poanessa/RobotHead/3D_printedObjects/Lips/20161202_165450.jpg

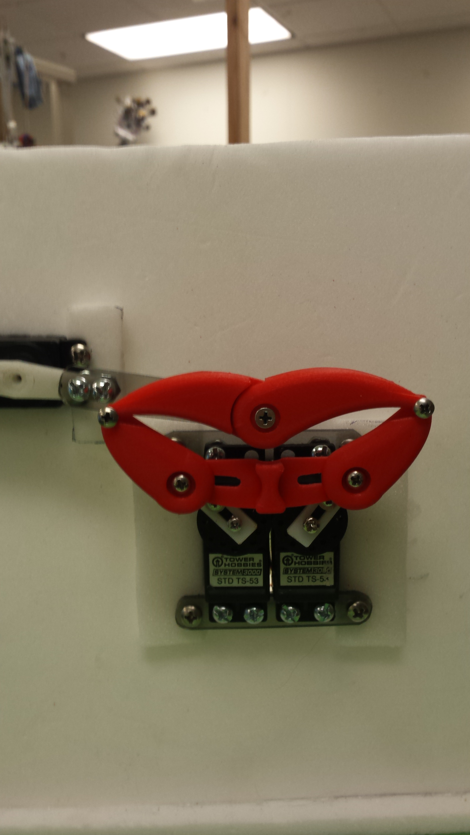
3D_printedObjects/Lips/20161202_165450.jpg
