poanessa/RobotHead/README.md

# RobotHead

Welcome to the PSU Robotics Department's robot head repository.<p>
Here you will find all files related to the production of the robot head created in in the 2016-2017 school term.<p>
This project was created by Tuna Poanessa (hardware) and Daniel Diaz (software).<p>
Have questions?  Please feel free to email me at poanessa@gmail.com
