poanessa/RobotHead/media/InternalStruc/readMe

This folder contains the finished assembly of the internal eyelid and eye structures
