poanessa/RobotHead/media/FinishedMech/ReadMe

This Folder shows the final assembly of the head mechanisms.
