poanessa/RobotHead/20170429_133849.jpg

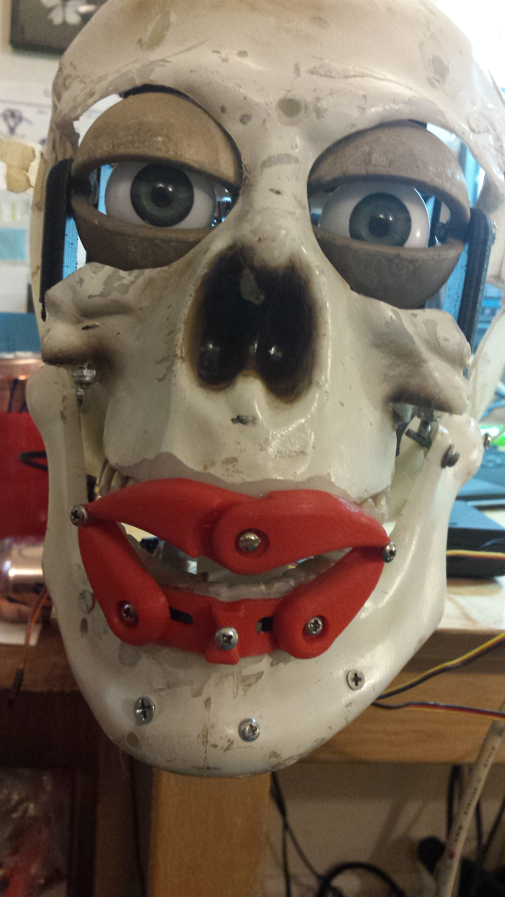
20170429_133849.jpg
