poanessa/RobotHead/media/20160930_150606.jpg

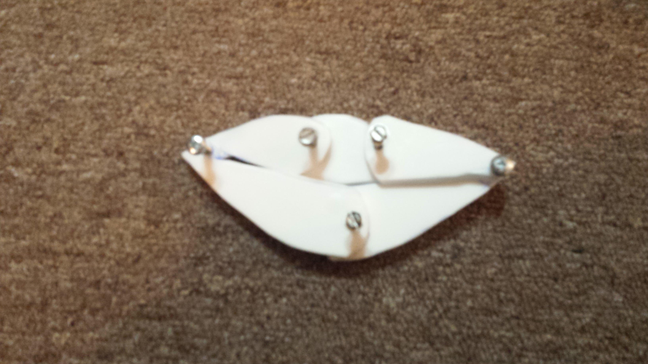
media/20160930_150606.jpg
