poanessa/RobotHead/media/20160930_150606_2.jpg

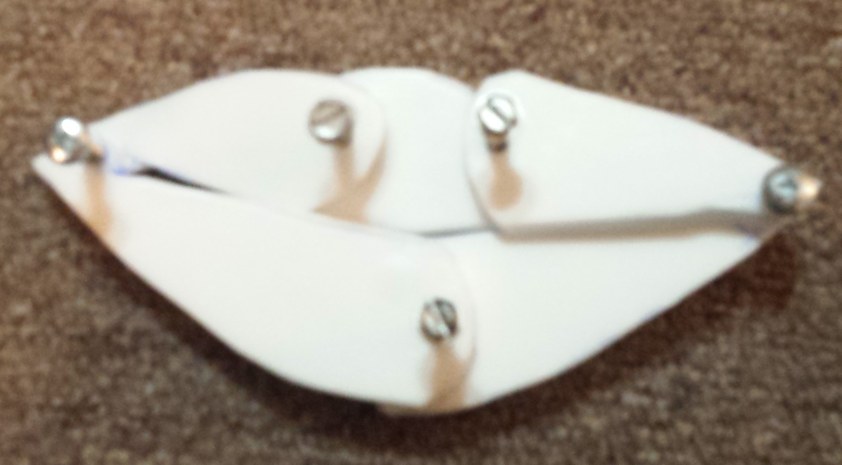
media/20160930_150606_2.jpg
