poanessa/RobotHead/media/20160930_150614.jpg

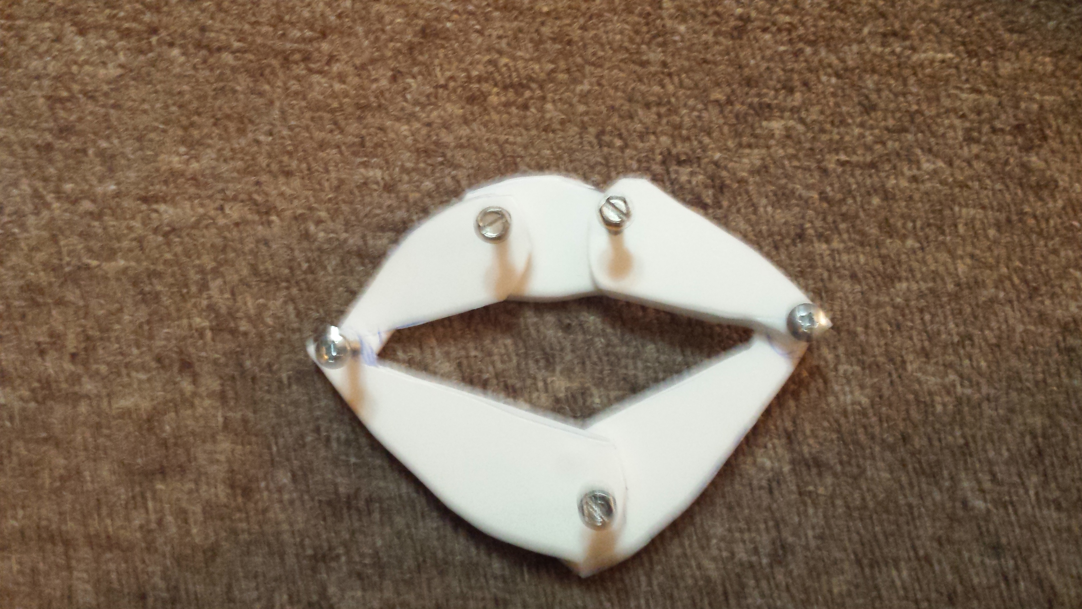
media/20160930_150614.jpg
