poanessa/RobotHead/media/20160930_150614_2.jpg

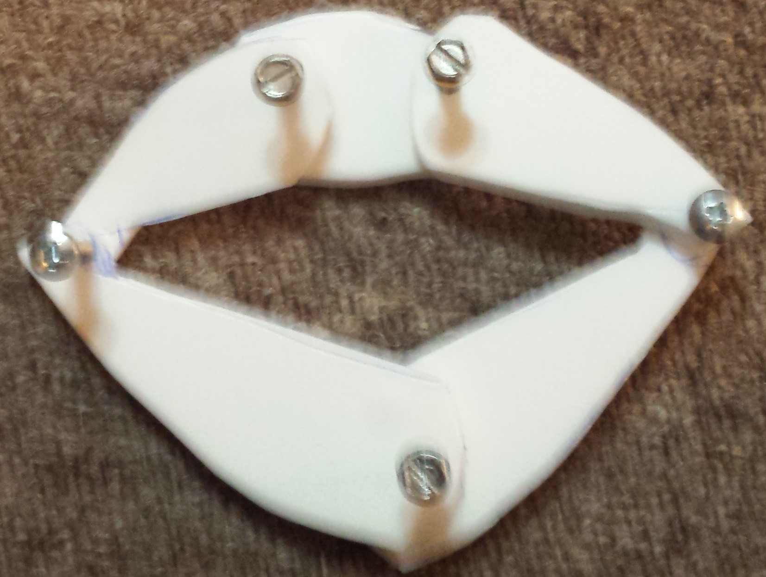
media/20160930_150614_2.jpg
