poanessa/RobotHead/media/20161104_113612.jpg

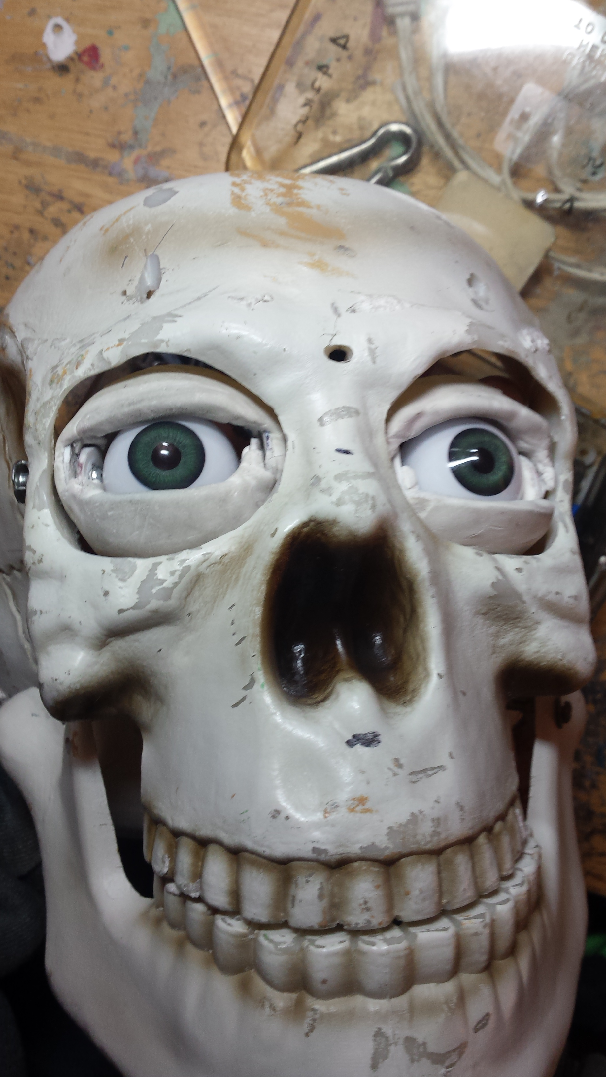
media/20161104_113612.jpg
