poanessa/RobotHead/media/20161111_124247.jpg

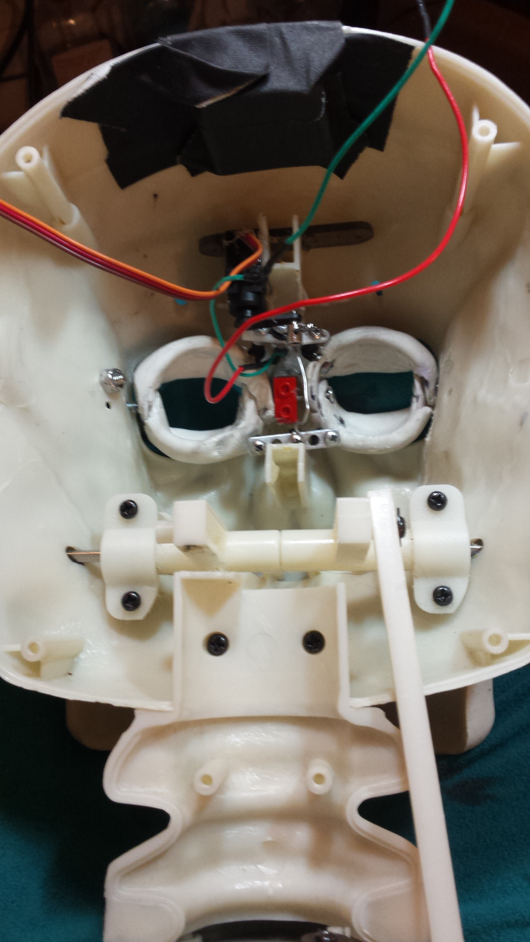
media/20161111_124247.jpg
