poanessa/RobotHead/media/20161127_152731.jpg

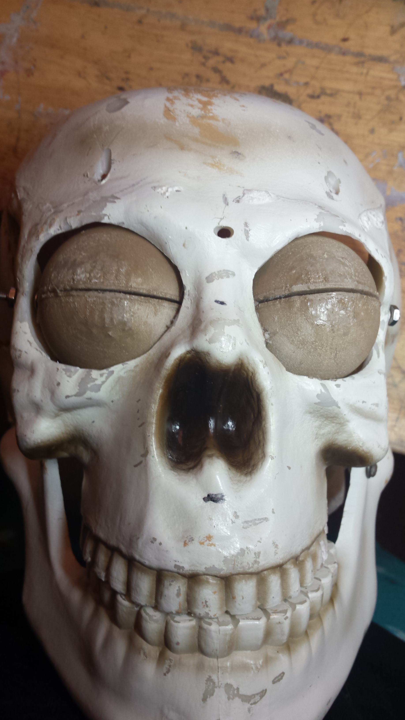
media/20161127_152731.jpg
