poanessa/RobotHead/media/20161127_152739.jpg

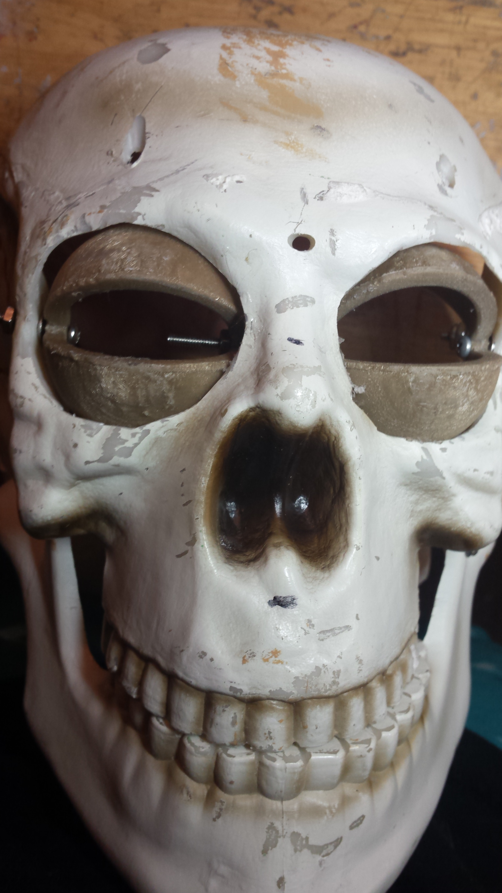
media/20161127_152739.jpg
