poanessa/RobotHead/media/20161127_152742.jpg

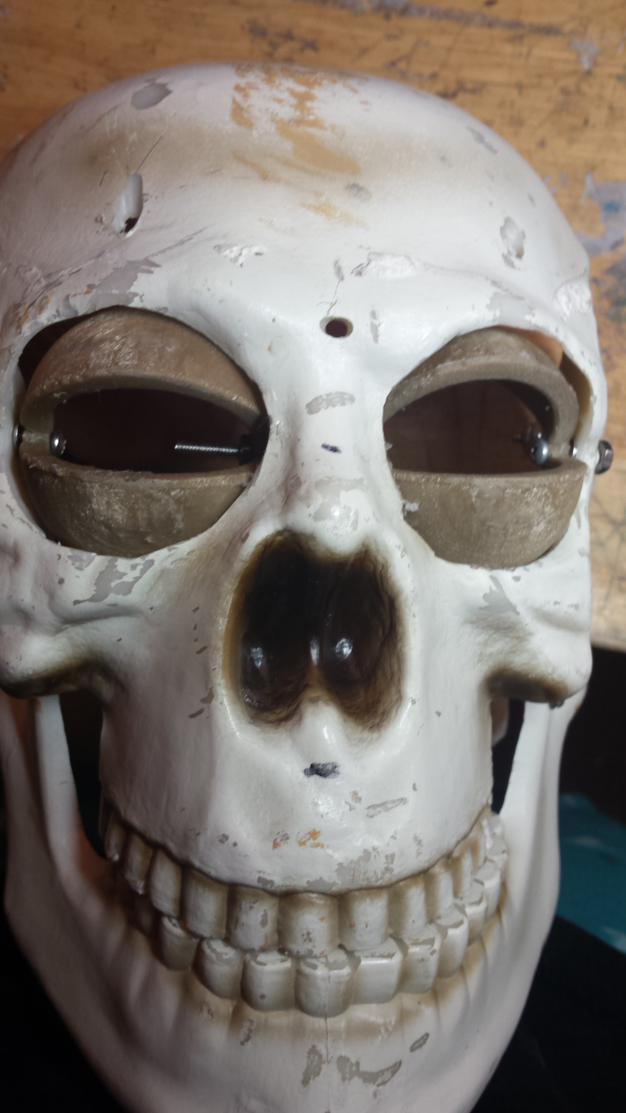
media/20161127_152742.jpg
