poanessa/RobotHead/media/20161127_154534.jpg

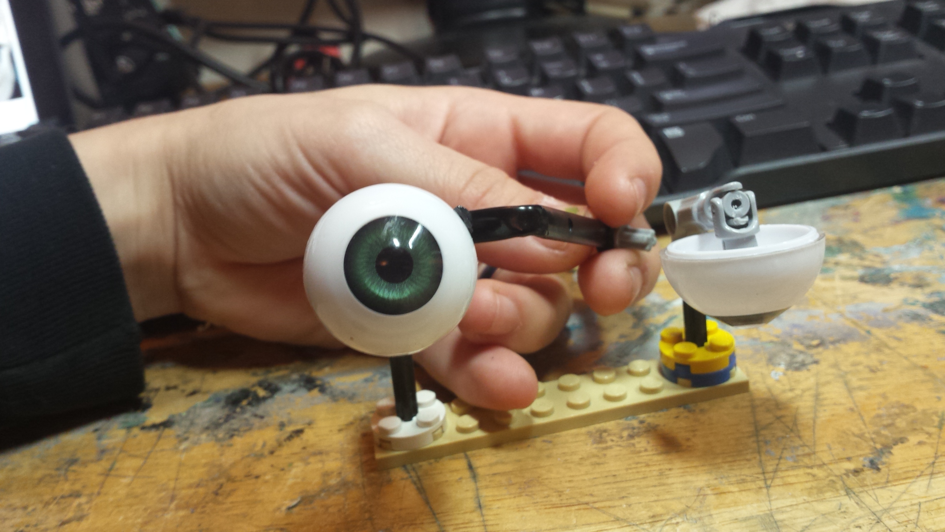
media/20161127_154534.jpg
