poanessa/RobotHead/media/20161127_154624.jpg

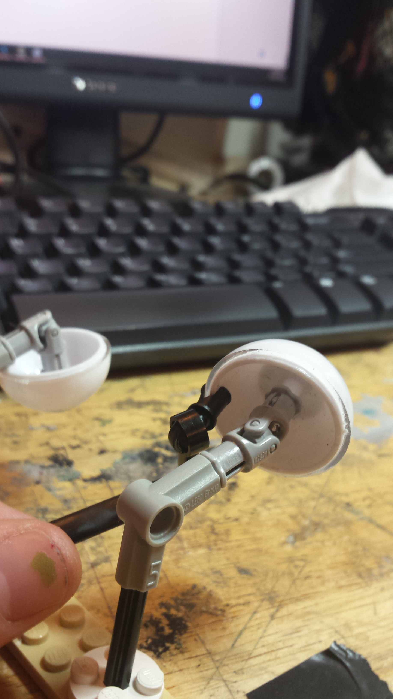
media/20161127_154624.jpg
