poanessa/RobotHead/media/20161127_161110.jpg

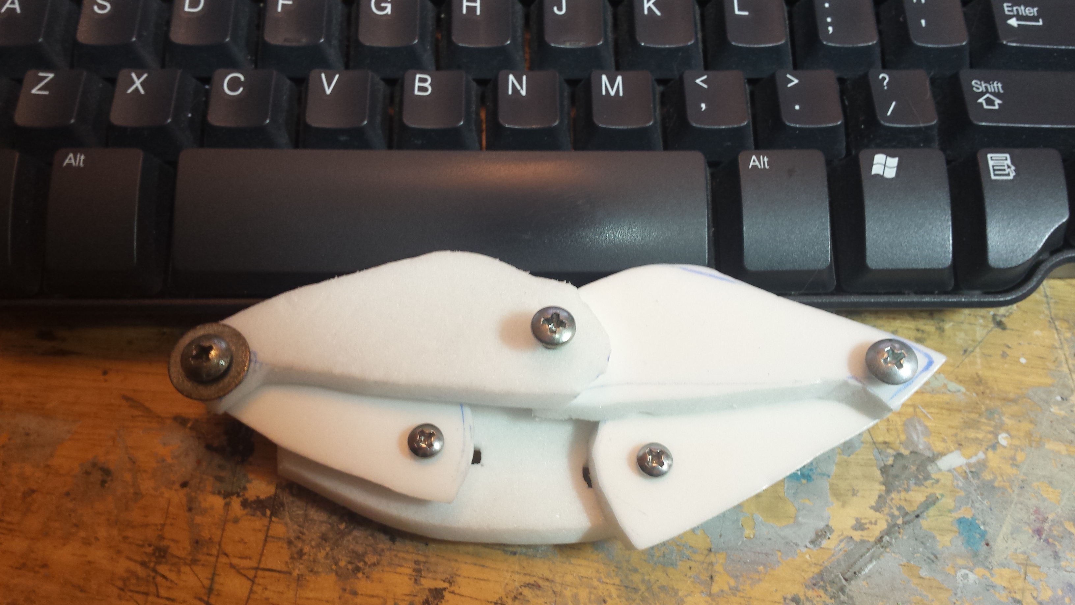
media/20161127_161110.jpg
