poanessa/RobotHead/media/20161127_161121.jpg

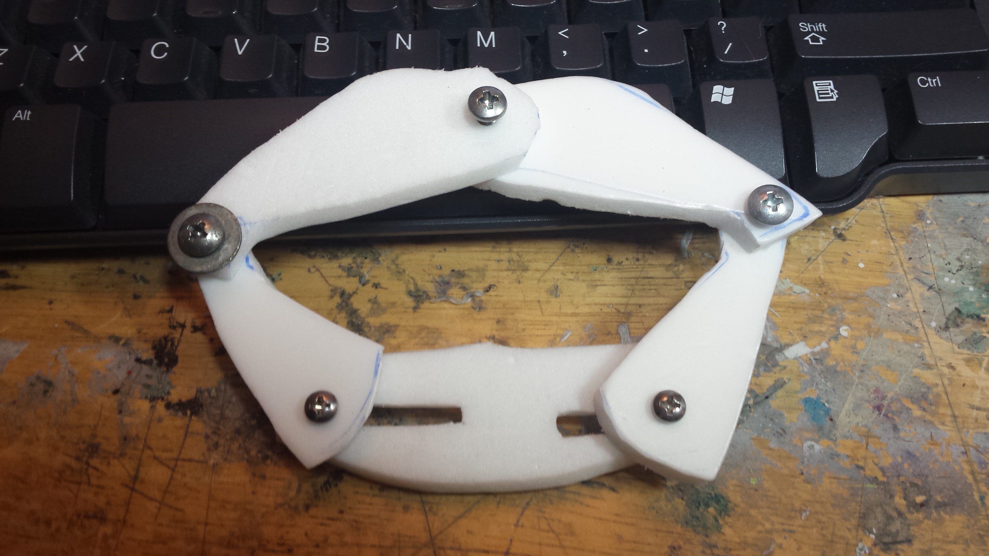
media/20161127_161121.jpg
