poanessa/RobotHead/media/20161127_161146.jpg

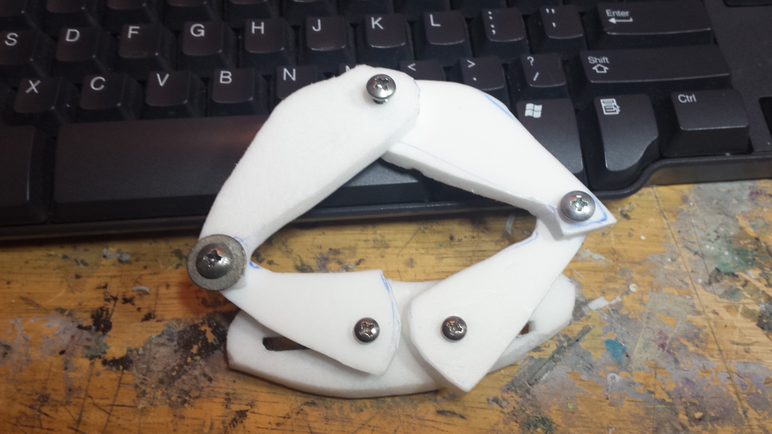
media/20161127_161146.jpg
