poanessa/RobotHead/media/20161127_161155.jpg

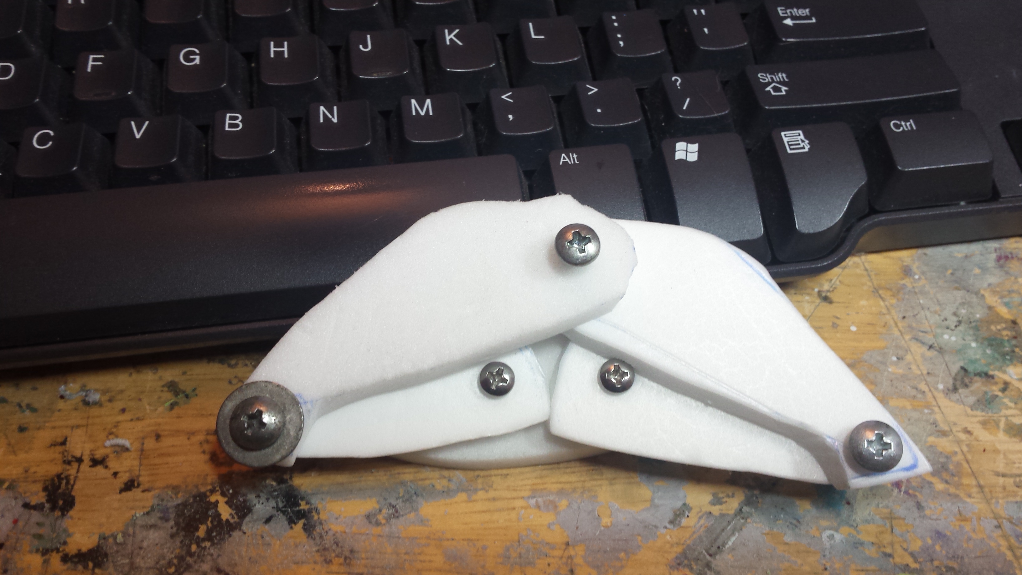
media/20161127_161155.jpg
