poanessa/RobotHead/media/20161127_163423.jpg

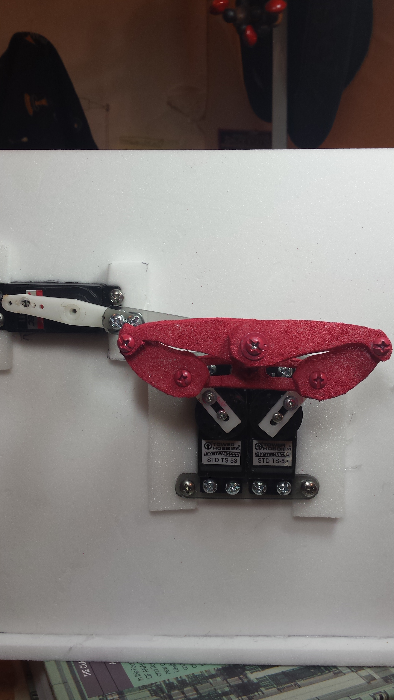
media/20161127_163423.jpg
