poanessa/RobotHead/media/20161127_163429.jpg

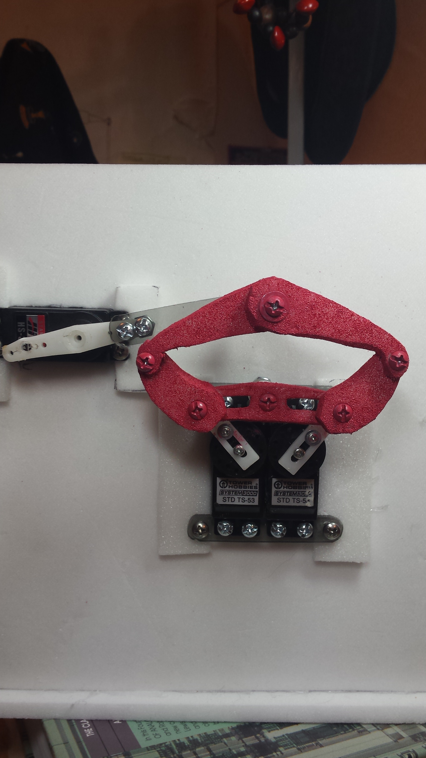
media/20161127_163429.jpg
