poanessa/RobotHead/media/20161127_163440.jpg

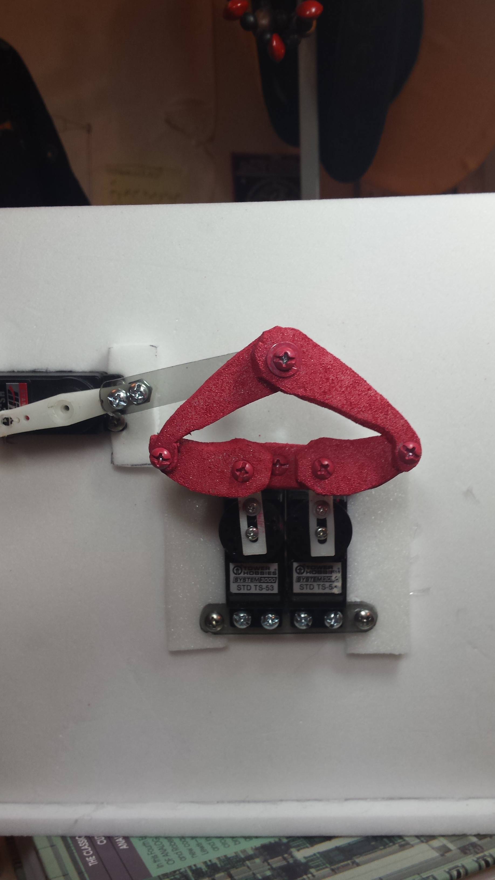
media/20161127_163440.jpg
