poanessa/RobotHead/media/20170212_110738.jpg

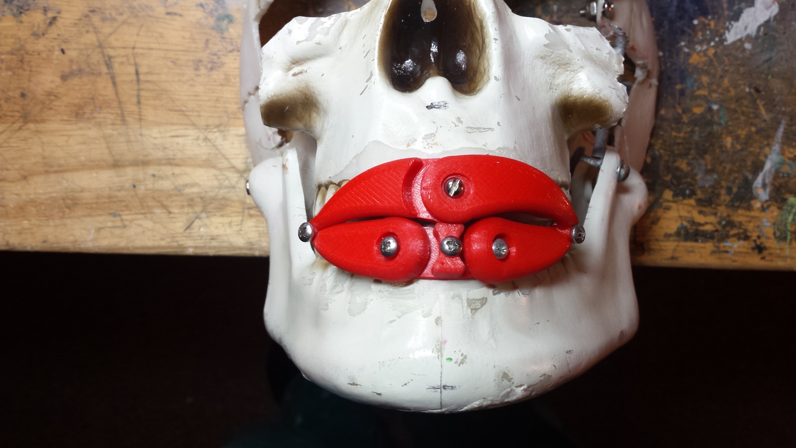
media/20170212_110738.jpg
