poanessa/RobotHead/media/20170212_110758.jpg

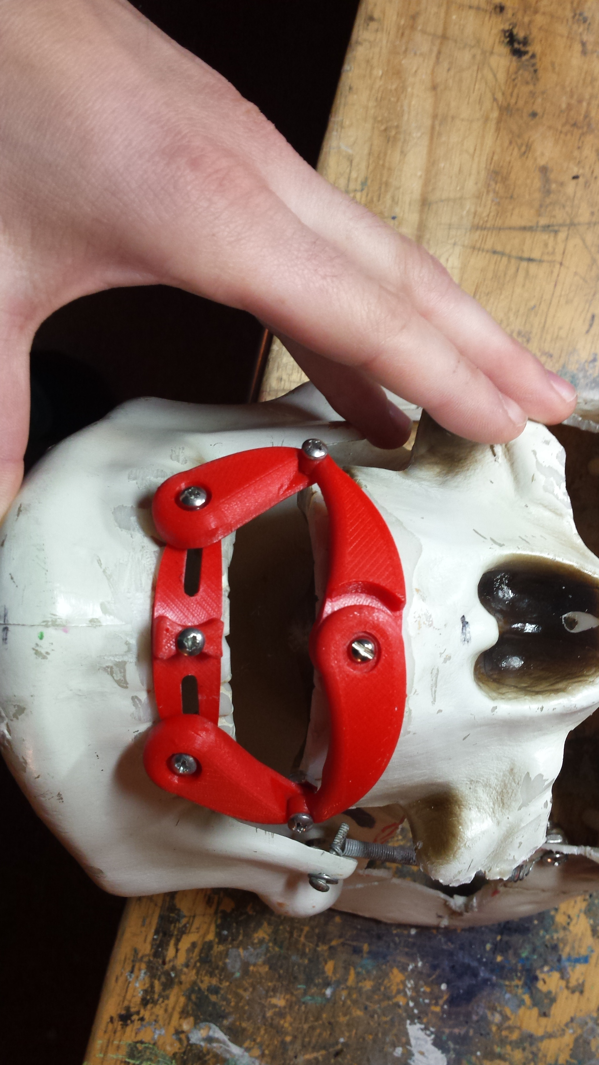
media/20170212_110758.jpg
