poanessa/RobotHead/media/20170212_110912.jpg

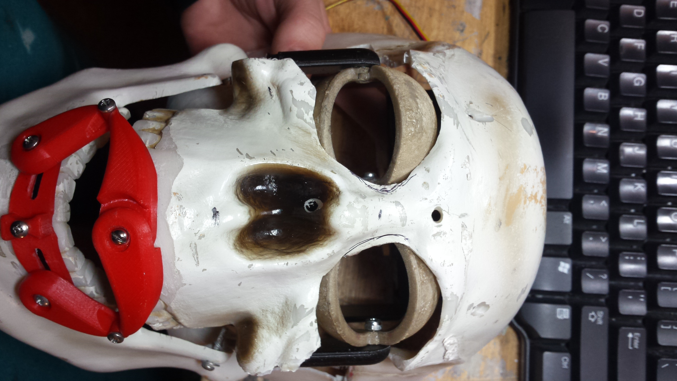
media/20170212_110912.jpg
