poanessa/RobotHead/media/eyelid_assm_1.png

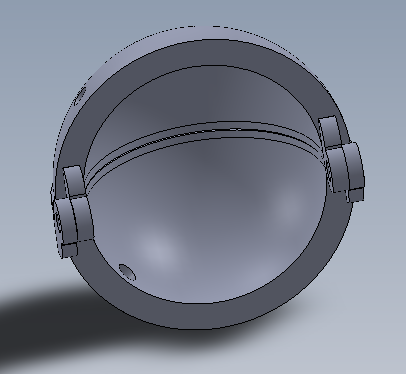
media/eyelid_assm_1.png
