poanessa/RobotHead/media/eyelid_assm_2.png

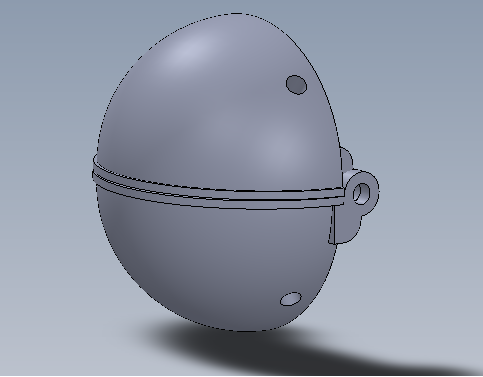
media/eyelid_assm_2.png
