poanessa/RobotHead/media/eyelid_assm_3.png

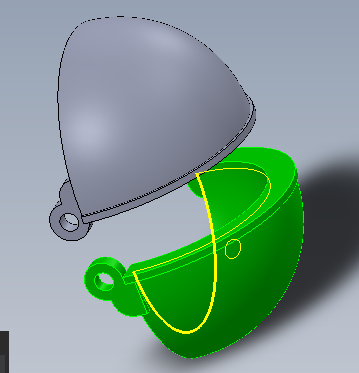
media/eyelid_assm_3.png
