poanessa/RobotHead/media/FinishedMech/20170429_134507.jpg

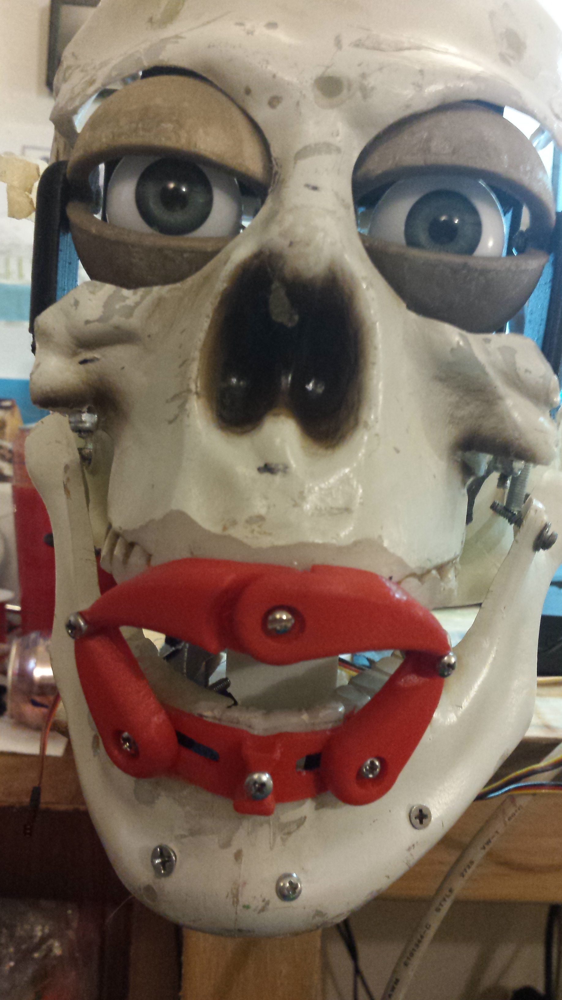
media/FinishedMech/20170429_134507.jpg
