poanessa/RobotHead/media/FinishedMech/20170429_135124.jpg

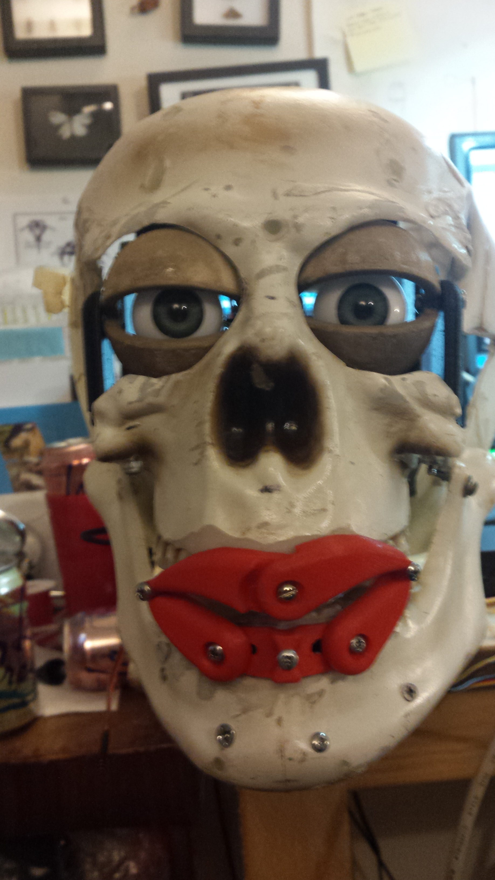
media/FinishedMech/20170429_135124.jpg
