poanessa/RobotHead/media/firstEyeMech.png

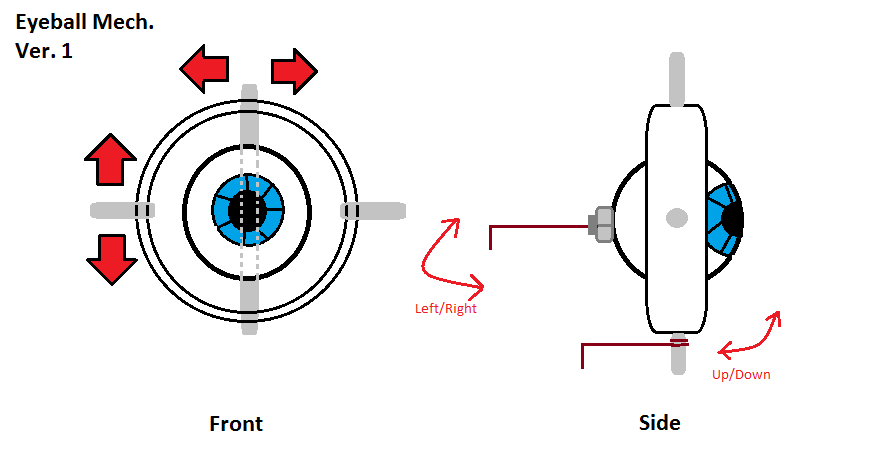
media/firstEyeMech.png
