poanessa/RobotHead/media/Internal_struct.png

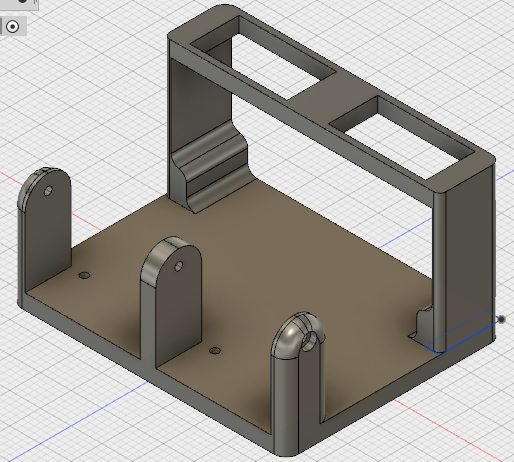
media/Internal_struct.png
