poanessa/RobotHead/media/InternalStruc/20170212_110822.jpg

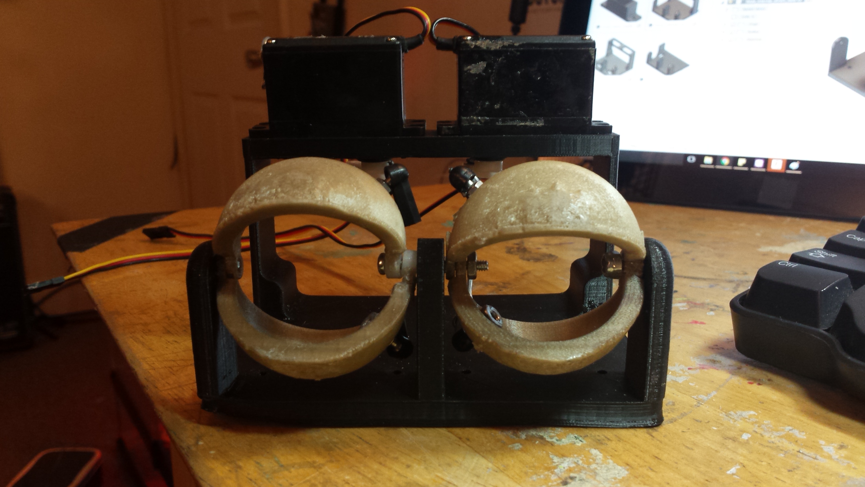
media/InternalStruc/20170212_110822.jpg
