poanessa/RobotHead/media/InternalStruc/20170212_110830.jpg

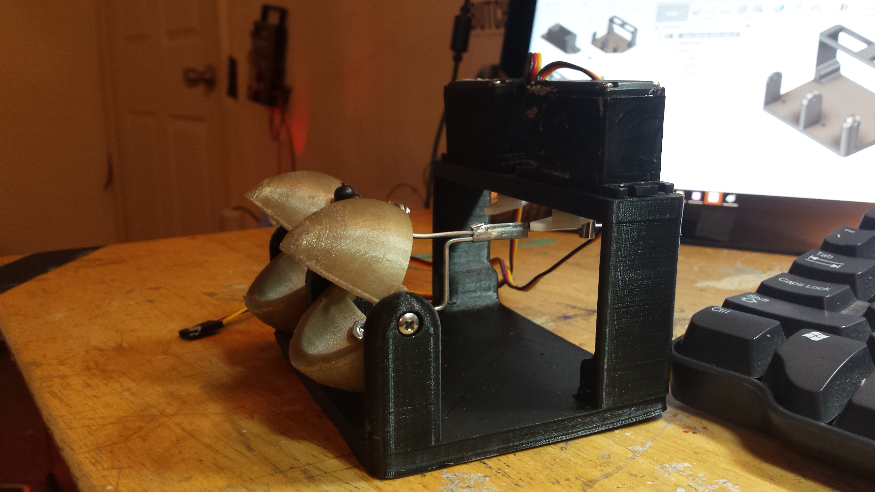
media/InternalStruc/20170212_110830.jpg
