poanessa/RobotHead/media/InternalStruc/20170226_142949.jpg

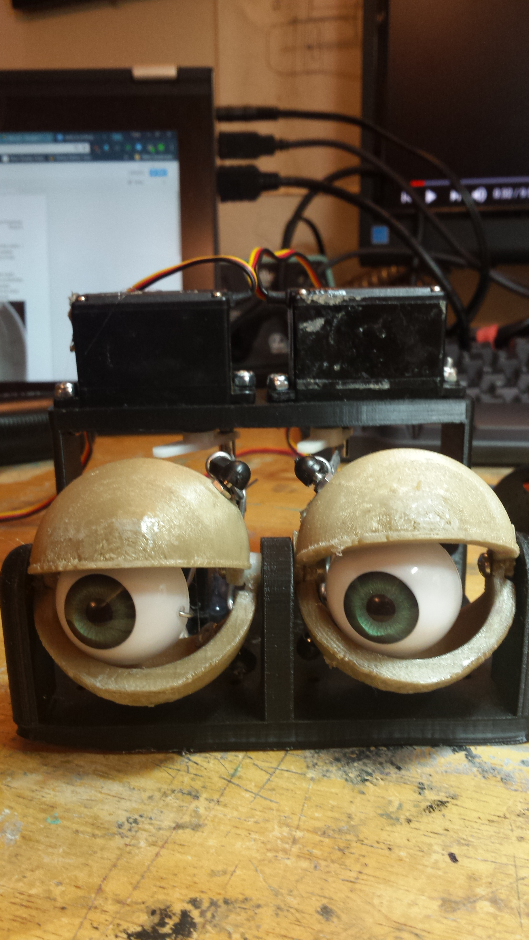
media/InternalStruc/20170226_142949.jpg
