poanessa/RobotHead/media/InternalStruc/20170226_143022.jpg

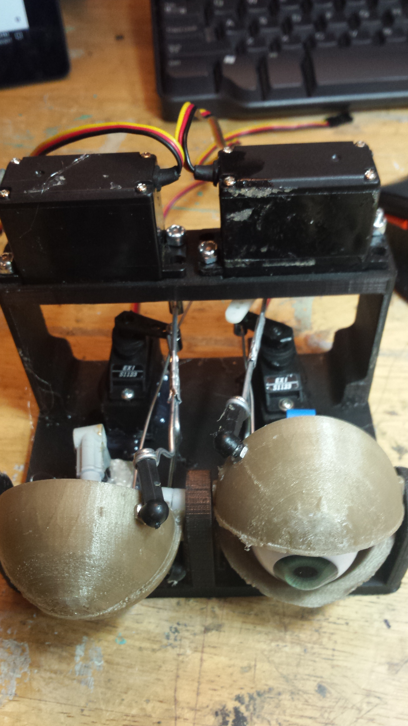
media/InternalStruc/20170226_143022.jpg
