poanessa/RobotHead/media/lip_assm_back.png

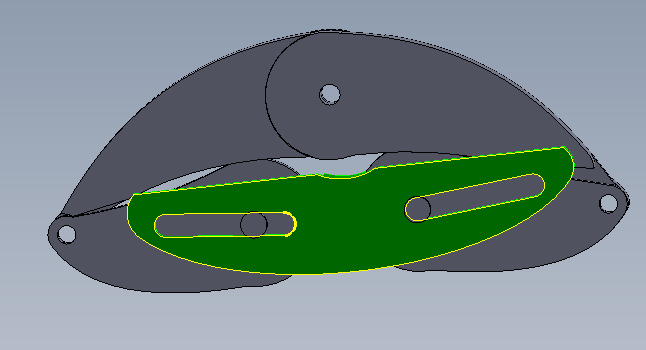
media/lip_assm_back.png
