poanessa/RobotHead/media/lip_assm_exploded.png

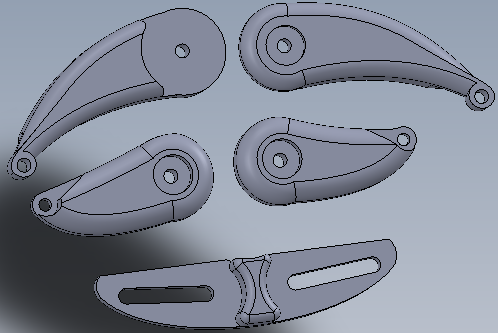
media/lip_assm_exploded.png
