poanessa/RobotHead/media/lip_assm_front_1.png

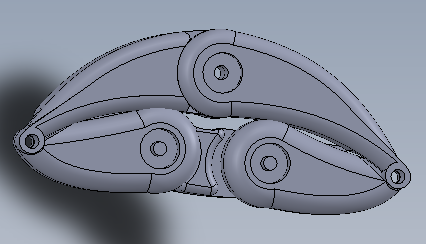
media/lip_assm_front_1.png
