poanessa/RobotHead/media/MaskDocumentation/signal-2017-06-06-193347-1.jpeg

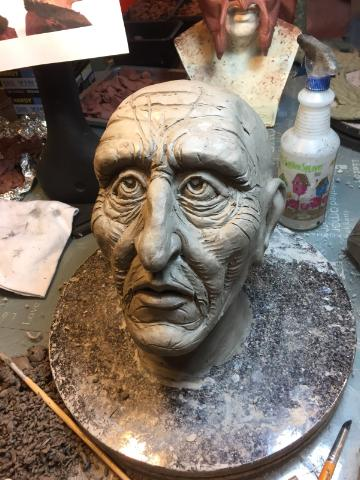
media/MaskDocumentation/signal-2017-06-06-193347-1.jpeg
