poanessa/RobotHead/media/MaskDocumentation/signal-2017-06-07-184037.jpeg

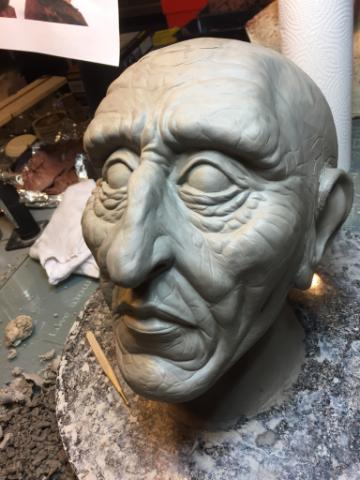
media/MaskDocumentation/signal-2017-06-07-184037.jpeg
