poanessa/RobotHead/media/MaskDocumentation/signal-2017-06-08-193707.jpeg

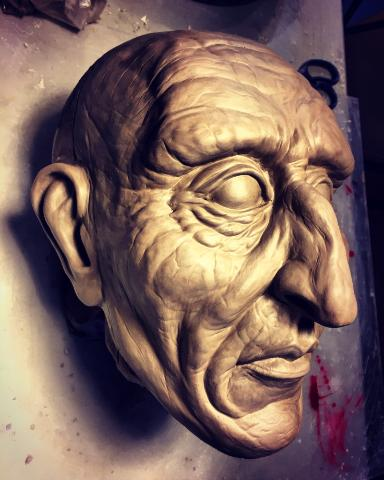
media/MaskDocumentation/signal-2017-06-08-193707.jpeg
