poanessa/RobotHead/media/MaskDocumentation/signal-2017-06-13-103711.jpeg

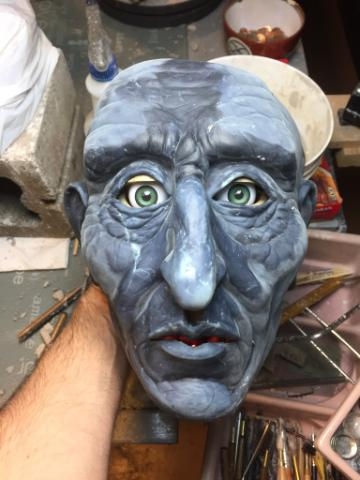
media/MaskDocumentation/signal-2017-06-13-103711.jpeg
