poanessa/RobotHead/media/secondEyeMech.png

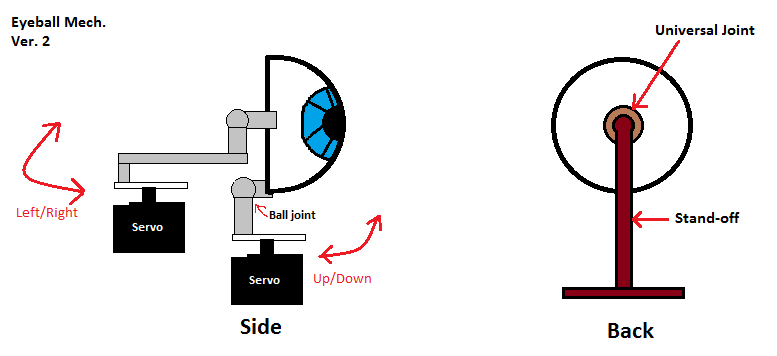
media/secondEyeMech.png
