poanessa/RobotHead/3D_printedObjects/Lips/lip_assm.SLDASM

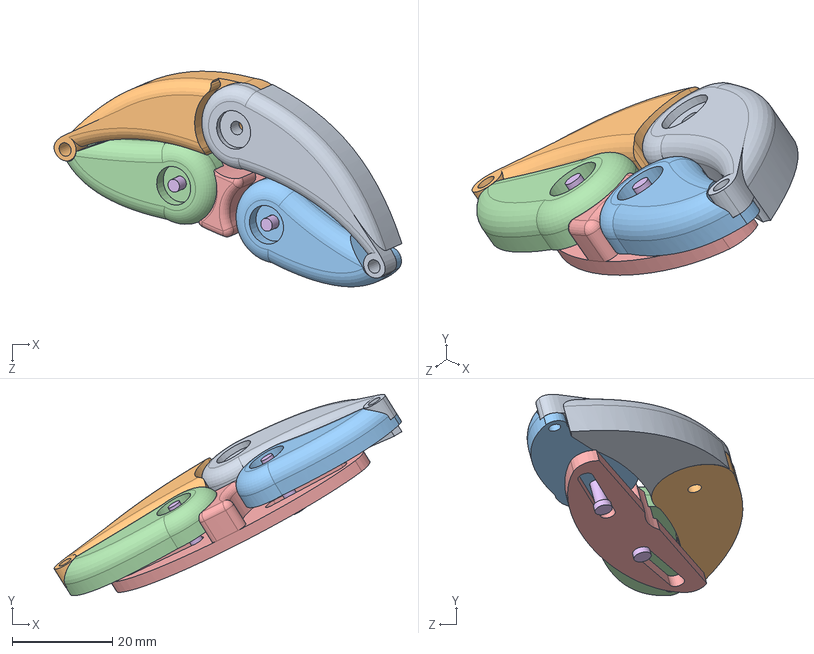
[picture p54: CAD file, 2017-05-31]
3D_printedObjects/Lips/lip_assm.SLDASM
69.4 x 40.2 x 43.0 mm
basic_top_Shape
basic_top_Shape - Copy
bottom1
bottom2
bottom_slider_draft
pin x 2
