poanessa/RobotHead/3D_printedObjects/eyelids/eyelidAssm.SLDASM

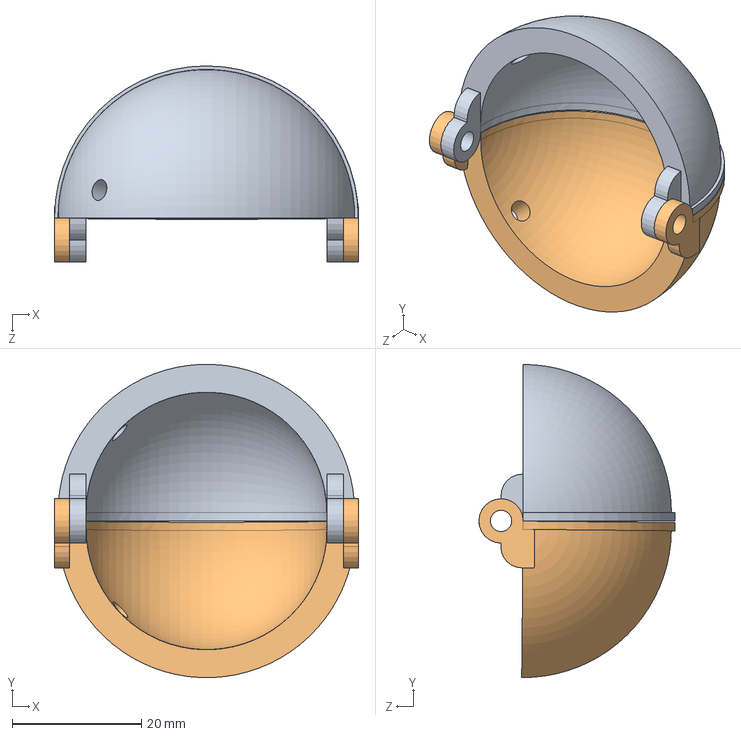
[picture p55: CAD file, 2017-05-31]
3D_printedObjects/eyelids/eyelidAssm.SLDASM
47.0 x 48.5 x 30.4 mm
bottomlid2_left
toplid2_left
