poanessa/RobotHead/3D_printedObjects/internal_head_struct.stl

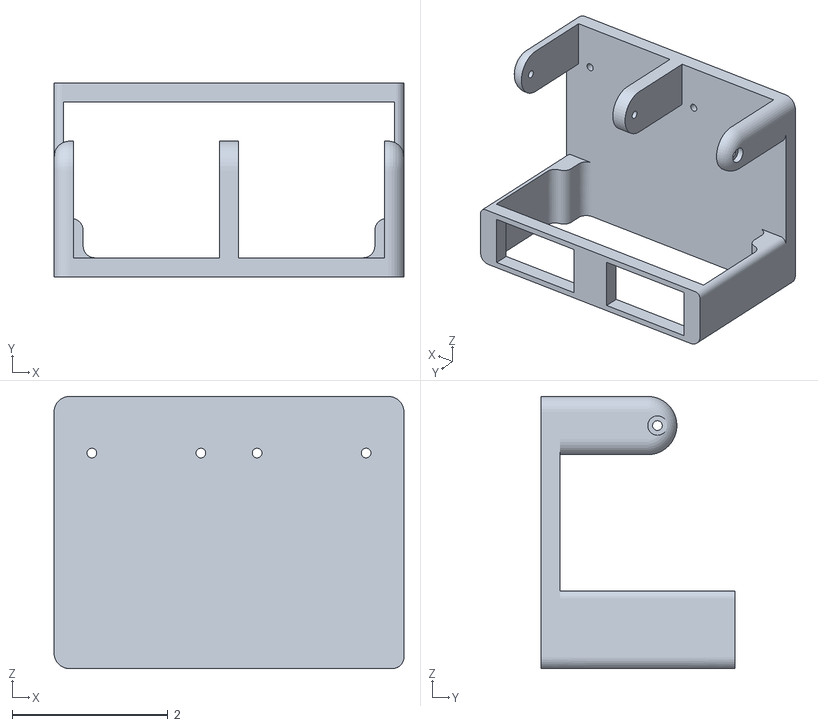
[picture p57: CAD file, 2017-05-31]
3D_printedObjects/internal_head_struct.stl
4.50 x 2.50 x 3.50
