poanessa/RobotHead/3D_printedObjects/eyelids/bottomlid2_left.SLDPRT

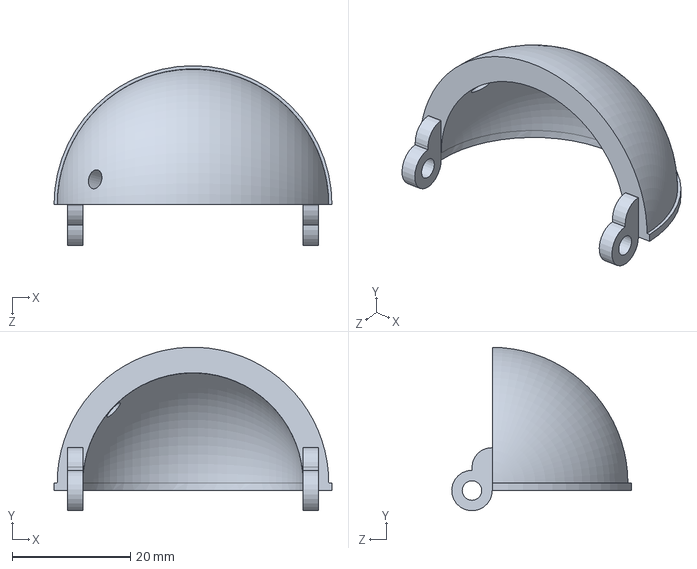
[picture p58: CAD file, 2017-05-31]
3D_printedObjects/eyelids/bottomlid2_left.SLDPRT
47.0 x 27.6 x 30.4 mm
