poanessa/RobotHead/3D_printedObjects/small_servo_mount.stl

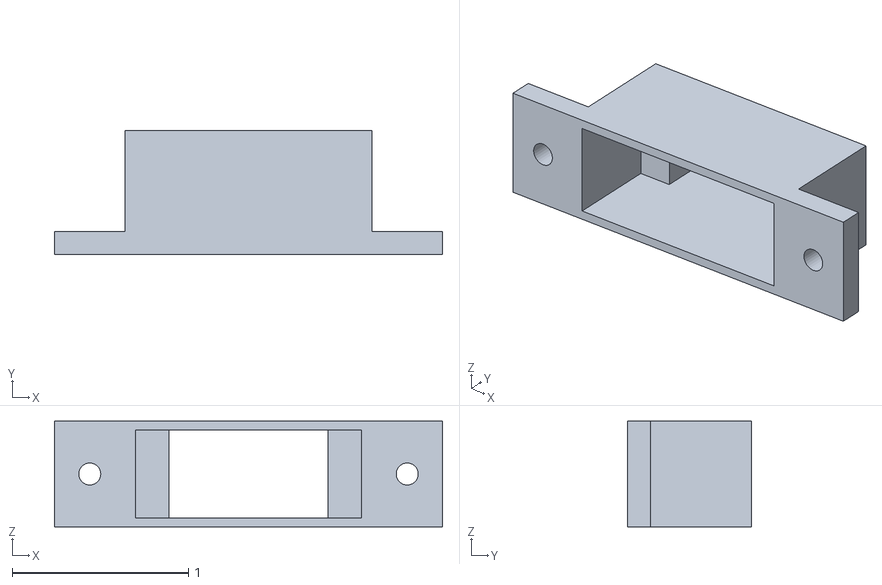
[picture p59: CAD file, 2017-05-31]
3D_printedObjects/small_servo_mount.stl
2.20 x 0.705 x 0.6
