poanessa/RobotHead/3D_printedObjects/eyelids/bottomlid.SLDPRT

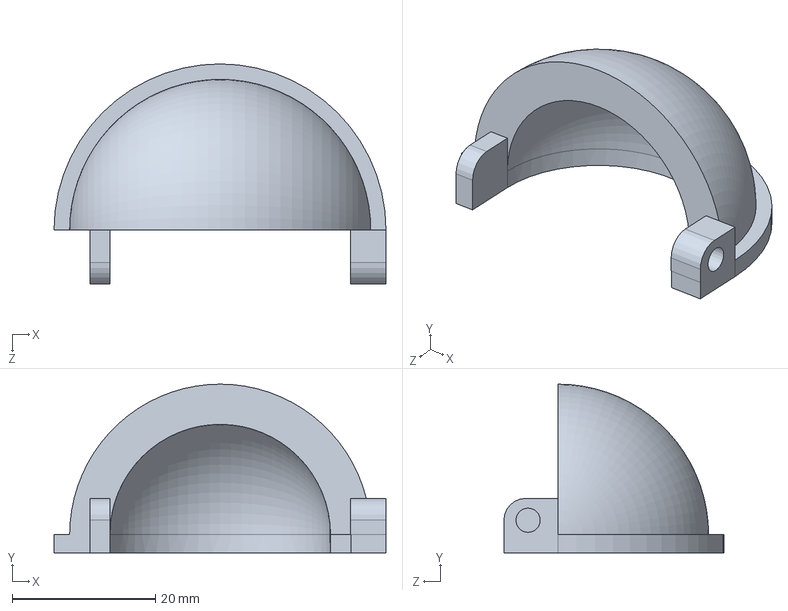
[picture p60: CAD file, 2017-05-31]
3D_printedObjects/eyelids/bottomlid.SLDPRT
46.4 x 23.6 x 30.8 mm
