poanessa/RobotHead/3D_printedObjects/Lips/pin.SLDPRT

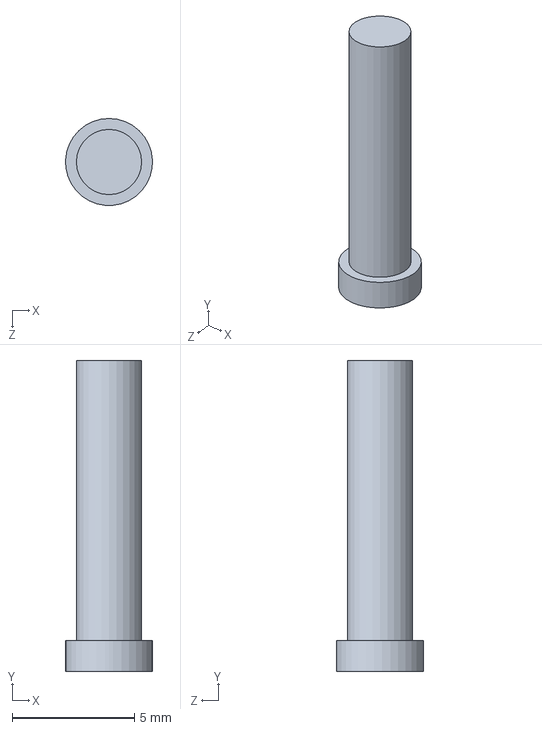
[picture p61: CAD file, 2017-05-31]
3D_printedObjects/Lips/pin.SLDPRT
3.55 x 12.7 x 3.56 mm
