poanessa/RobotHead/3D_printedObjects/Lips/bottom2.SLDPRT

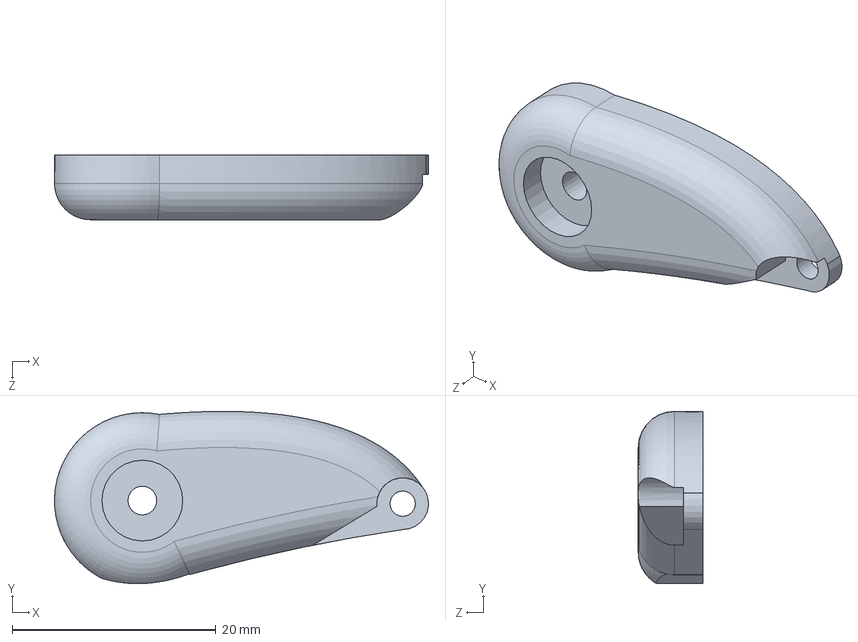
[picture p62: CAD file, 2017-05-31]
3D_printedObjects/Lips/bottom2.SLDPRT
36.7 x 16.9 x 6.35 mm
