poanessa/RobotHead/3D_printedObjects/Lips/bottom1.SLDPRT

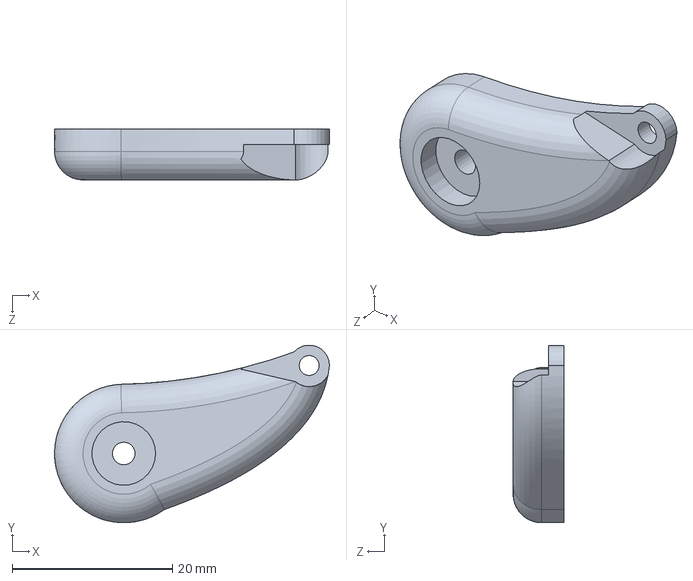
[picture p63: CAD file, 2017-05-31]
3D_printedObjects/Lips/bottom1.SLDPRT
34.3 x 22.1 x 6.35 mm
