poanessa/RobotHead/3D_printedObjects/Lips/bottom_slider_draft.SLDPRT

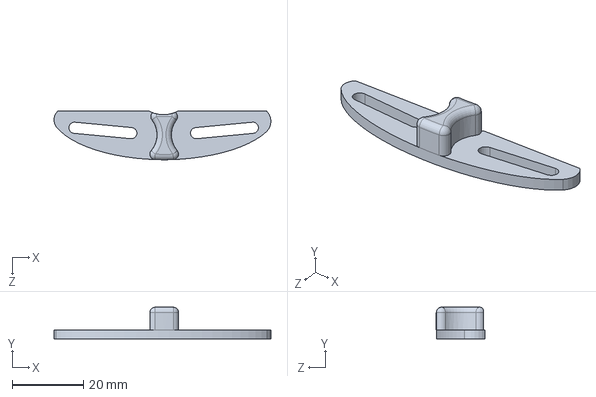
[picture p64: CAD file, 2017-05-31]
3D_printedObjects/Lips/bottom_slider_draft.SLDPRT
60.7 x 8.89 x 13.6 mm
