poanessa/RobotHead/3D_printedObjects/Lips/basic_top_Shape.SLDPRT

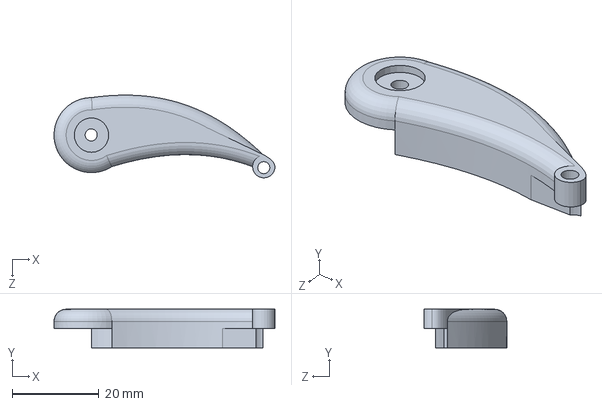
[picture p65: CAD file, 2017-05-31]
3D_printedObjects/Lips/basic_top_Shape.SLDPRT
50.9 x 8.89 x 19.1 mm
