poanessa/RobotHead/3D_printedObjects/Lips/basic_top_Shape - Copy.SLDPRT

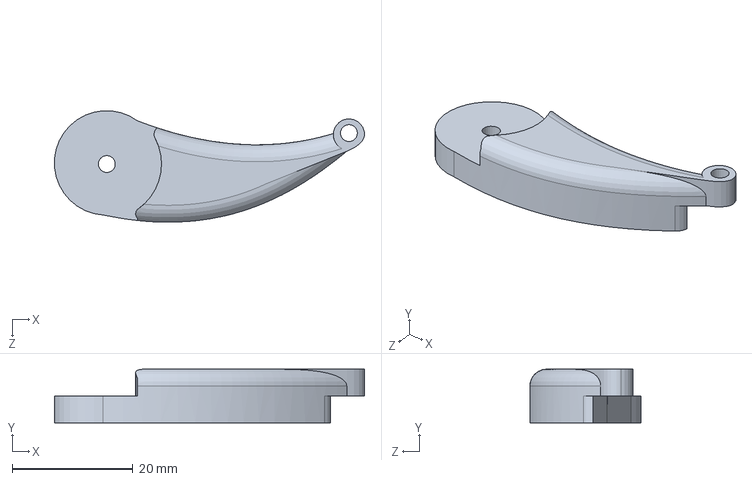
[picture p66: CAD file, 2017-05-31, an earlier design]
3D_printedObjects/Lips/basic_top_Shape - Copy.SLDPRT
51.2 x 8.89 x 18.4 mm
