poanessa/RobotHead/(list of files, cad)

Other CAD files:
3D_printedObjects/eyelids/toplid2_left.SLDPRT
3D_printedObjects/eyelids/toplid2.SLDPRT
3D_printedObjects/eyelids/bottomlid2.SLDPRT
