poanessa/RobotHead/PrintedCircuit/ReadMe

This folder contains the start of a printed circuit board to control the head that is arduino based.  
The schematic is complete but the breadboard layout needs work!
