poanessa/RobotHead/3D_printedObjects/Lips/20161202_165525.jpg

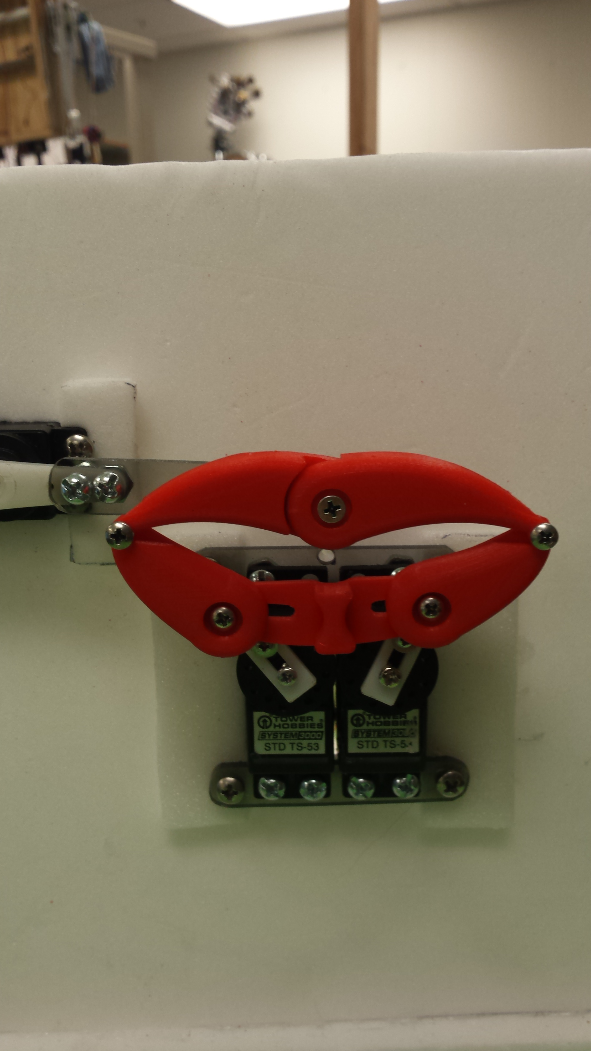
3D_printedObjects/Lips/20161202_165525.jpg
