poanessa/RobotHead/PrintedCircuit/arduinoschematic1.brd

## EAGLE design PrintedCircuit/arduinoschematic1.brd (2017-05-31)

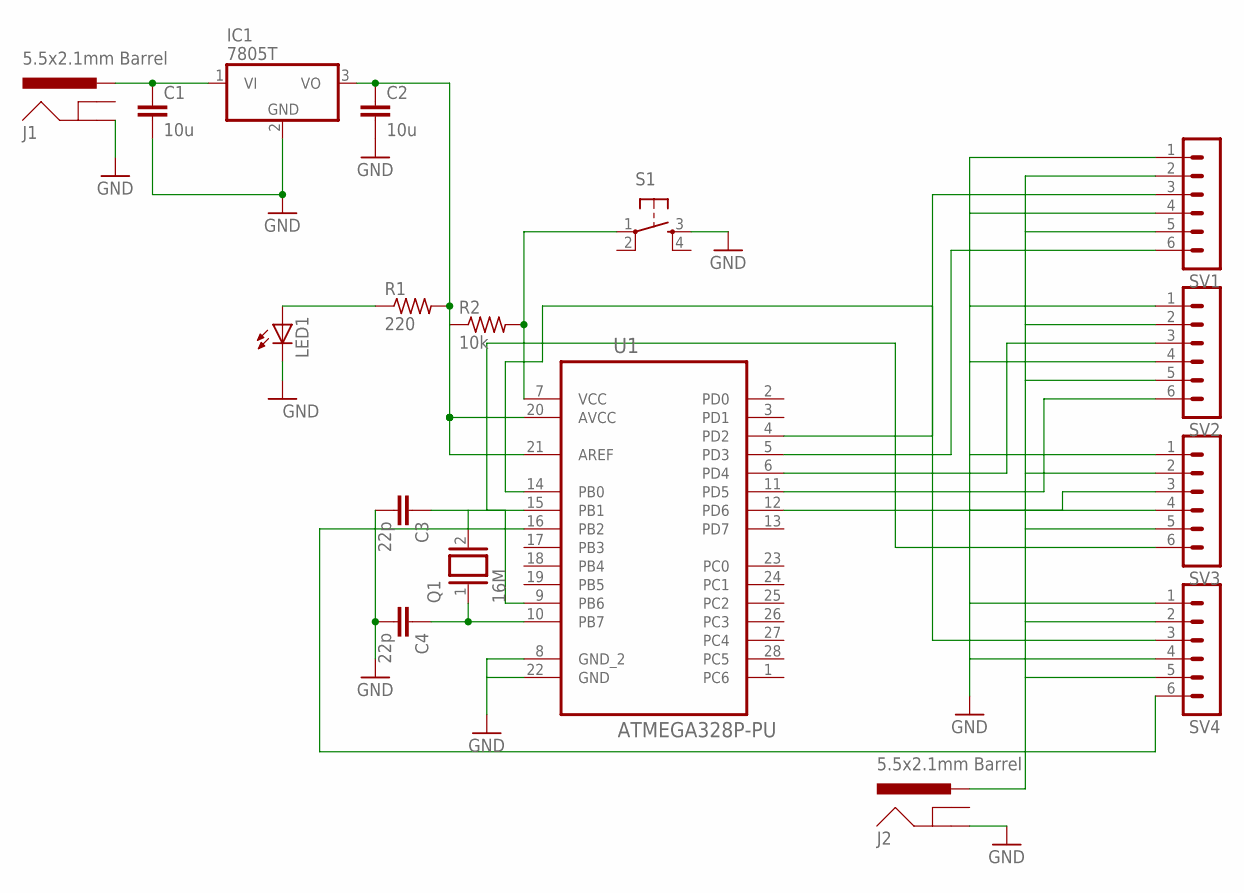
[picture p70: schematic arduinoschematic1.sch]

Parts:
C1, C2: 10u; C050-030X075
C3, C4: 22p; C025-030X050
IC1: 7805T; TO220H
J1, J2: 5.5x2.1mm Barrel; POWER_JACK_SMD
LED1: LEDSQR2X5; LED2X5
Q1: 16M; QS
R1: 220; 0204/5
R2: 10k; 0204/5
S1: TAC_SWITCHSMD; TACTILE-PTH
SV1, SV2, SV3, SV4: MA06-1
U1: ATMEGA328P-PU; DIP254P762X457-28

Connections:
GND: C1.2, C2.2, C3.2, C4.2, IC1.2 (GND), J1.P$4 (GND), J2.P$4 (GND), LED1.K (C), S1.3, SV1.1, SV1.4, SV2.1, SV2.4, SV3.1, SV3.4, SV4.1, SV4.4, U1.8 (GND_2), U1.22 (GND)
unnamed: C2.1, IC1.3 (VO), R1.2, R2.1, U1.20 (AVCC), U1.21 (AREF)
unnamed: R2.2, S1.1, U1.7 (VCC)
unnamed: LED1.A, R1.1
unnamed: C4.1, Q1.1, U1.10 (PB7)
unnamed: SV1.3, U1.4 (PD2)
unnamed: C1.1, IC1.1 (VI), J1.VIN0 (PWR)
unnamed: C3.1, Q1.2, U1.9 (PB6)
unnamed: SV1.6, U1.5 (PD3)
unnamed: SV2.3, U1.6 (PD4)
unnamed: SV2.6, U1.11 (PD5)
unnamed: SV3.3, U1.12 (PD6)
unnamed: SV3.6, U1.14 (PB0)
unnamed: SV4.3, U1.15 (PB1)
unnamed: SV4.6, U1.16 (PB2)
unnamed: J2.VIN0 (PWR), SV1.2, SV1.5, SV2.2, SV2.5, SV3.2, SV3.5, SV4.2, SV4.5

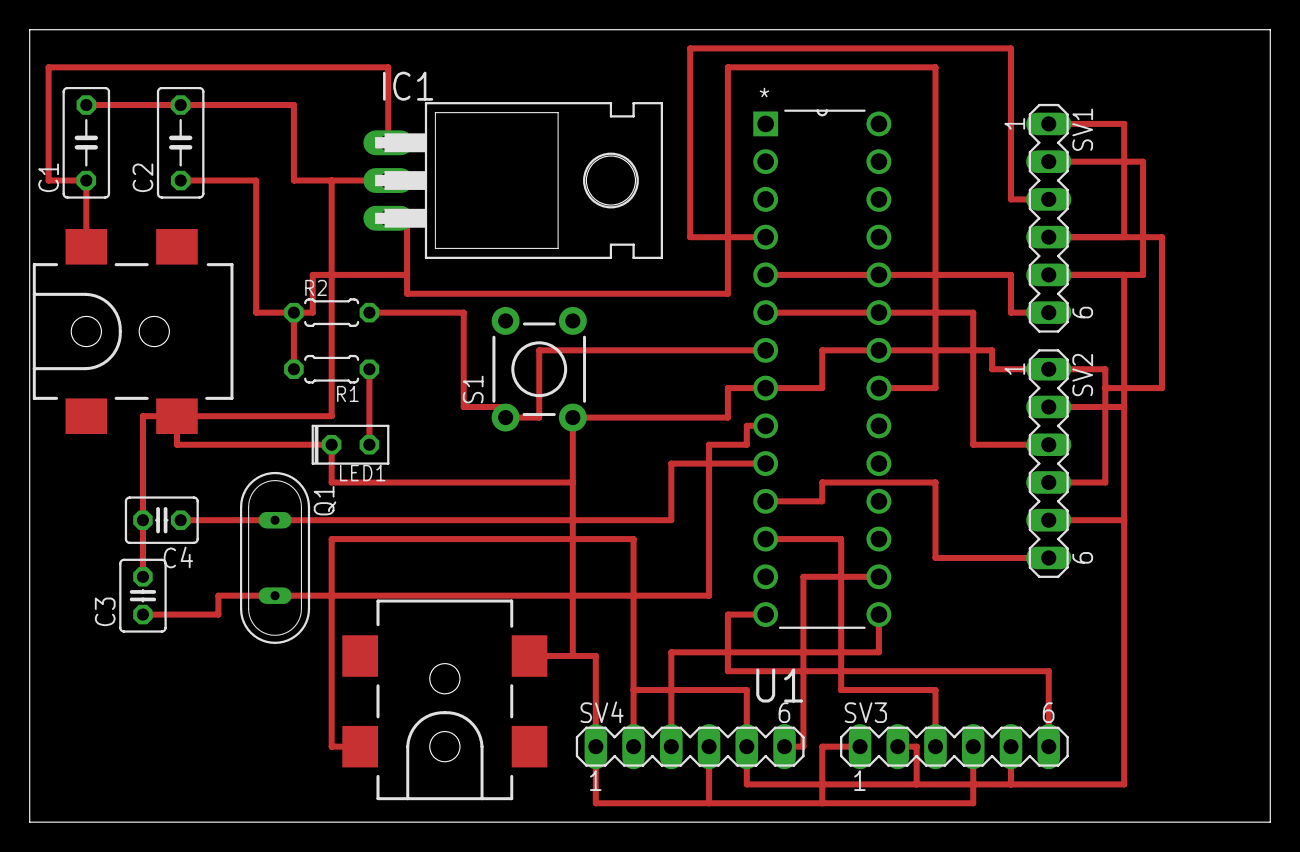
[picture p71: board arduinoschematic1.brd from above]

Board: 2 copper layers, 83.5 x 53.3 mm, 17 parts (0 on the bottom side), 16 nets.
